sachi1645/Analog-PID-Motor-Speed-Controller/Presentation Slides/presentation.pptx

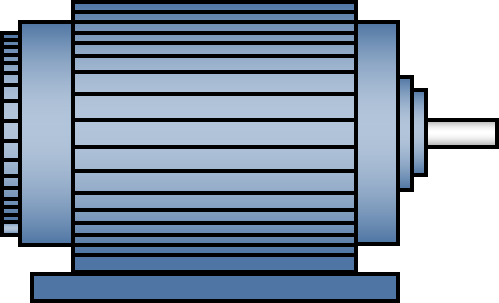
[picture p3: figure]
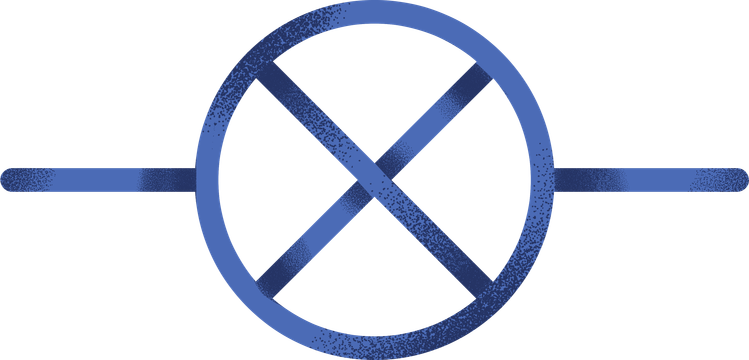
[picture p4: figure]

Group 13

PID Motor
Controller

EN2111 - Electronic Circuit Design

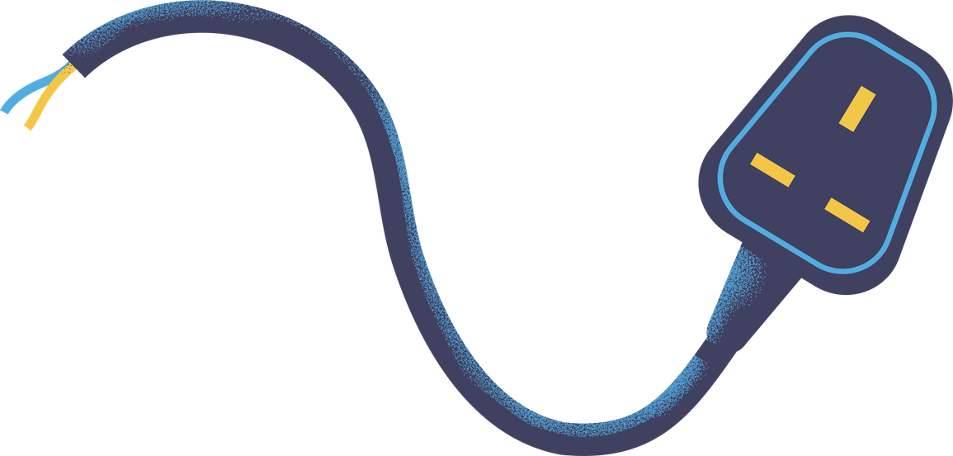
[picture p5: figure]
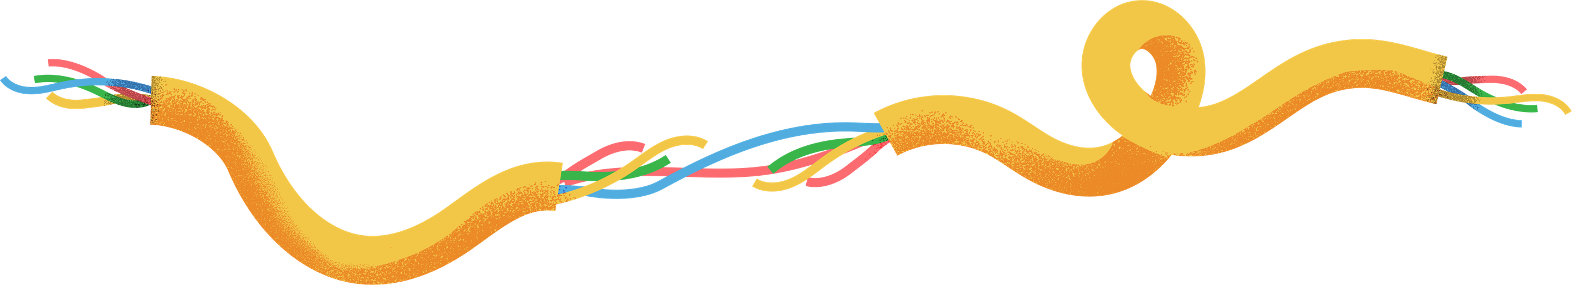
[picture p6: figure]

## Slide 2

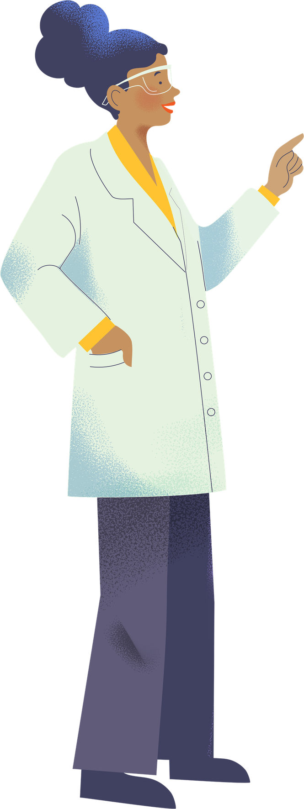
[picture p7: figure]

Introduction

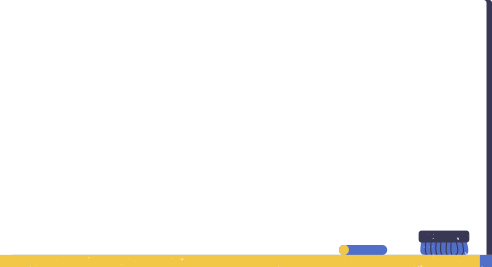
[picture p8: figure]

In this project, we design an analog PID-based motor speed controller that maintains constant motor speed despite load variations.The system uses
  - A reference speed input
  - Feedback from motor encoder
  - Analog PID control
  - PWM-based motor drive

## Slide 3

Block Diagram

1

FeedBack
Generation

  - F-V converter

2

PID Controller

  - Integrator
  - Differentiator
  - Differential Amplifier
  - Summing Amplifier

3

Driver Stage

  - PWM generator
(Relaxation Oscillator+
Integrator
Comparator)
  - Motor Driver

## Slide 4

FeedBack Generation

F-V Conversion

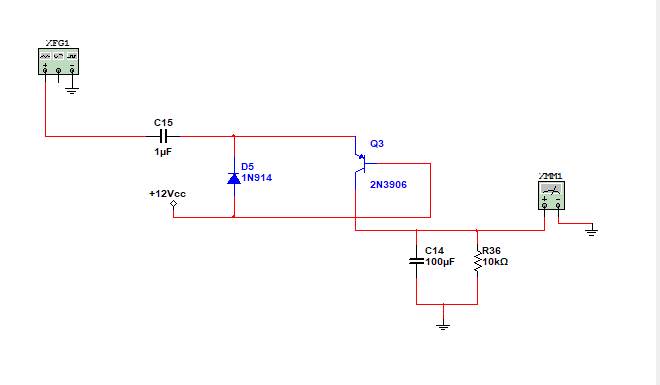
[picture p9: figure]

## Slide 5

PID Controller

This is the core of the system.
Reduce error between desired and actual speed
Improve stability and response
  - Proportional (P): reacts to present error
  - Integral (I): removes steady-state error
  - Derivative (D): reduces overshoot and improves stability
Implemented using op-amp networks

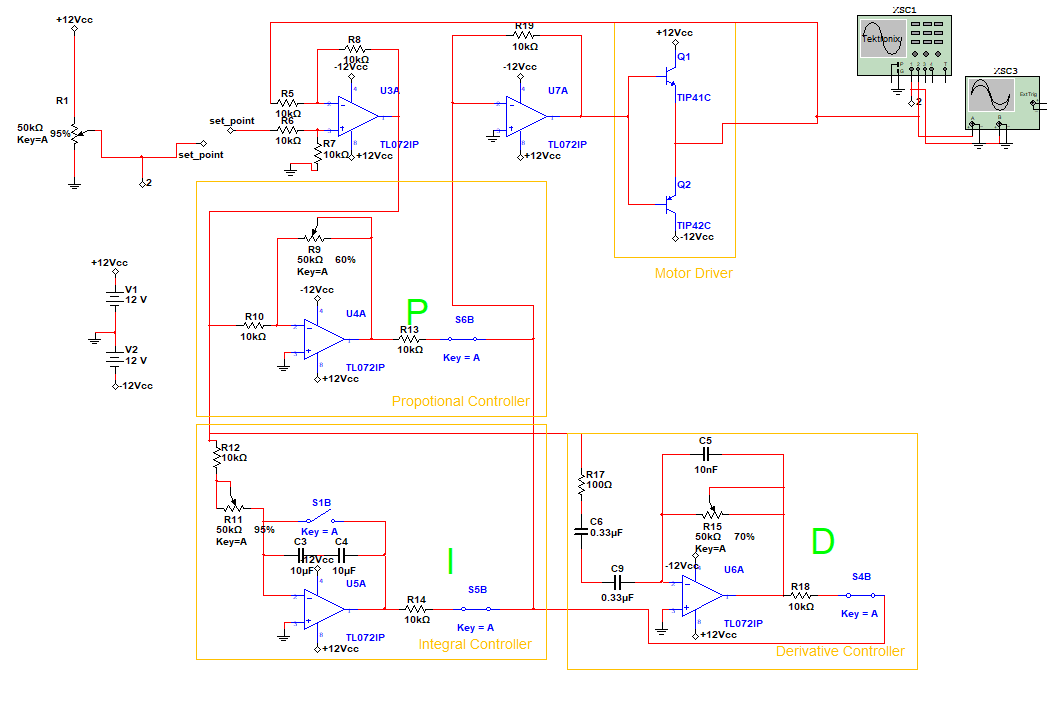
[picture p10: figure]

## Slide 6

PWM Generation

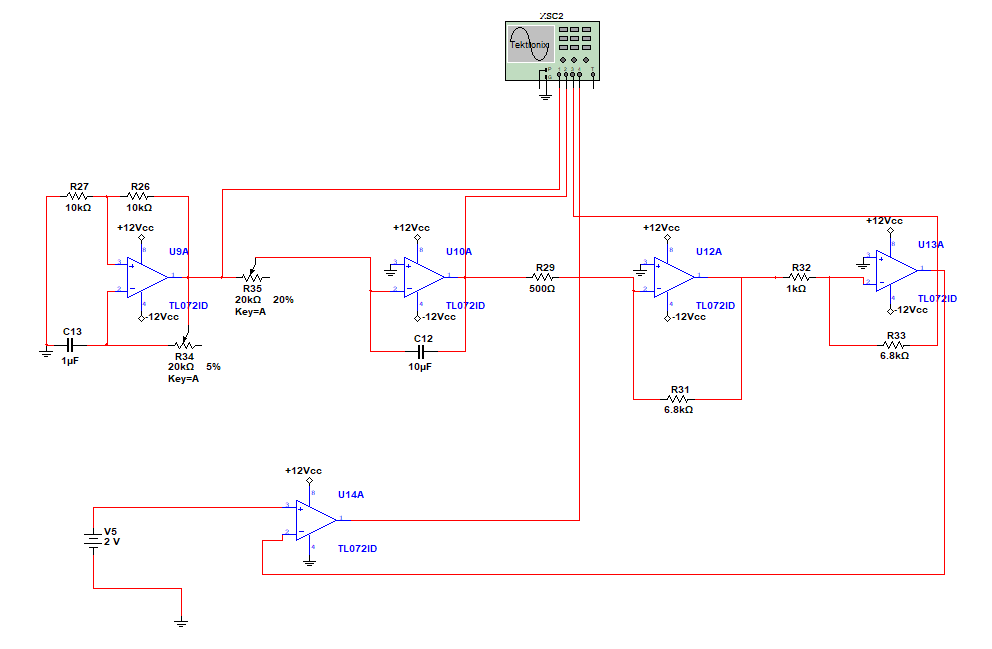
[picture p11: figure]

## Slide 7

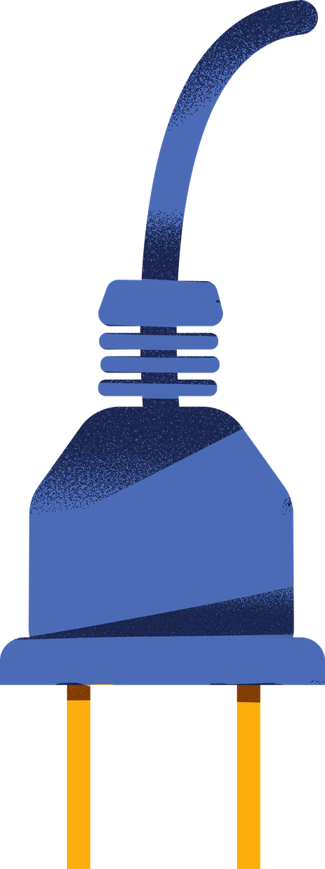
[picture p12: figure]

Op Amps-
  - TL071 - Has higher slew rate,low noise
  - LM741 -General purpose
Transistors-
  - 2N3906P-switching/amplification
  - TIP41C- Motor Driver
DIodes-
  - 1N914-Fast switching
Motor -
  - N20-built in magnetic encoder
Supply Voltage-
  - 6V
  - ±12V Dual Supply

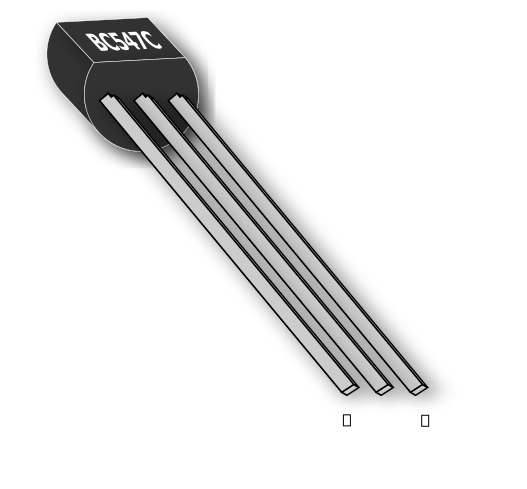
[picture p13: figure]

Component
Selection
&
Specification

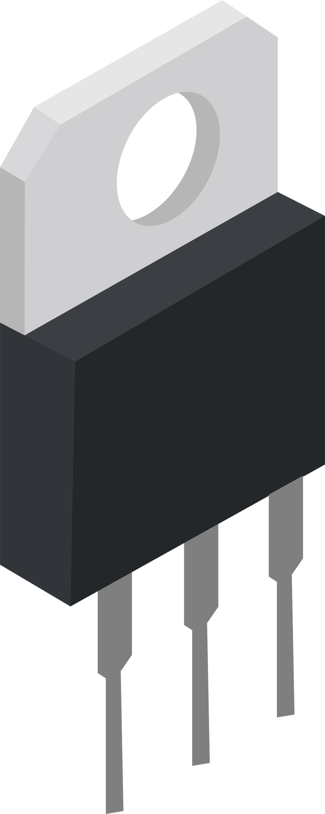
[picture p14: figure]
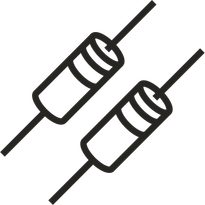
[picture p15: figure]
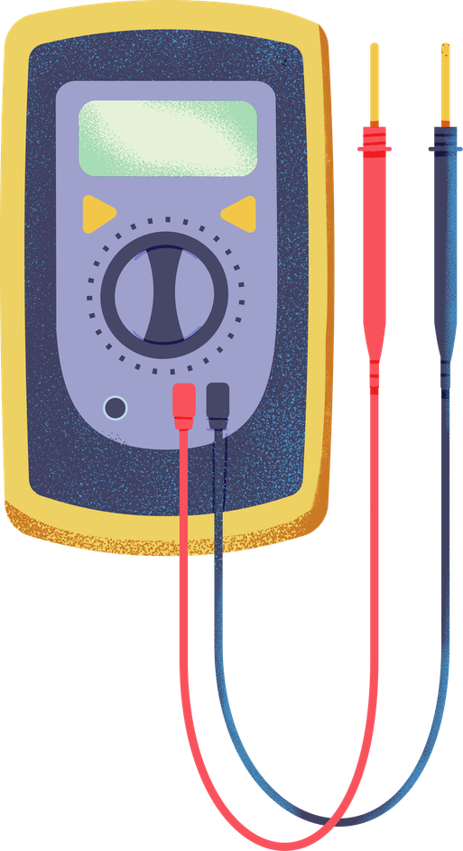
[picture p16: figure]

## Slide 8

Bread Board Implementation

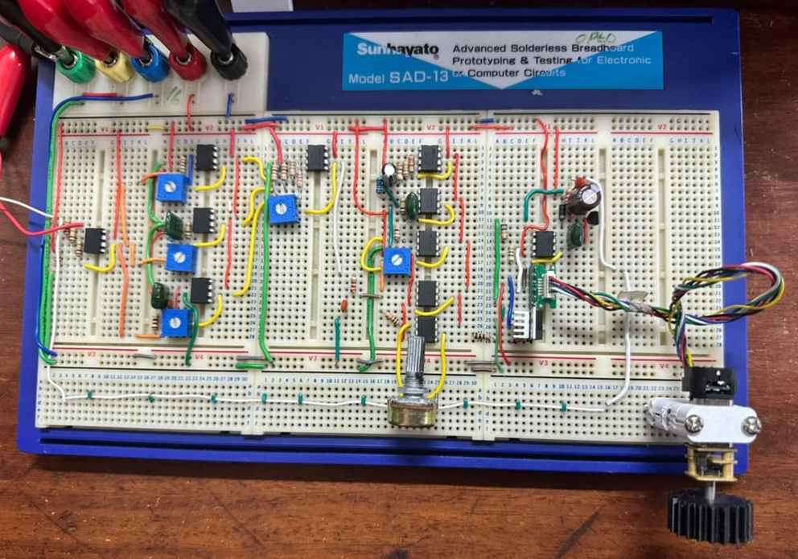
[picture p17: figure]
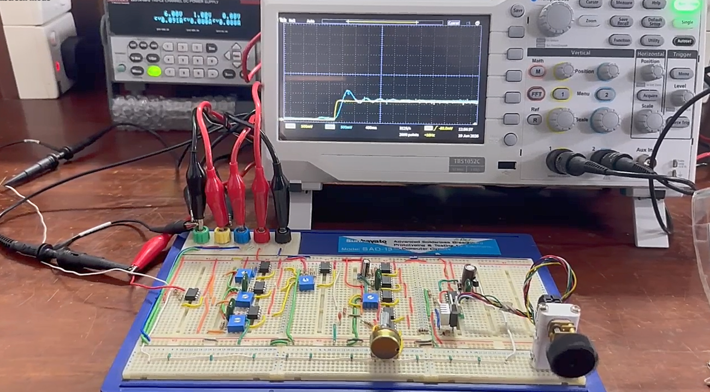
[picture p18: figure]
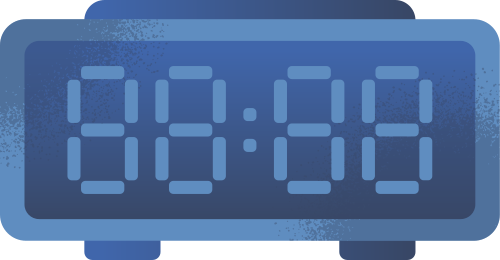
[picture p19: figure]

## Slide 9

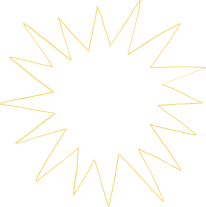
[picture p20: figure]
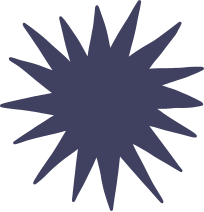
[picture p21: figure]

Thank You.

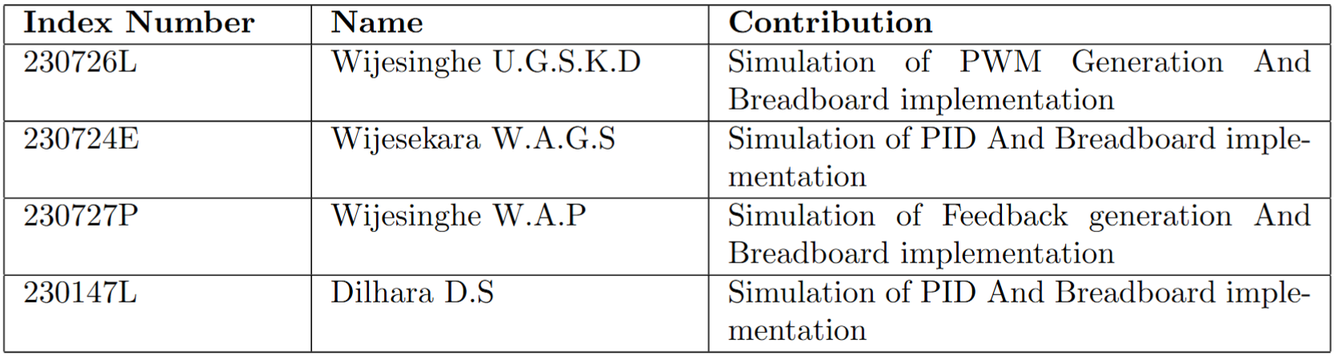
[picture p22: figure]
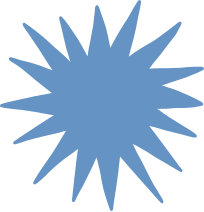
[picture p23: figure]
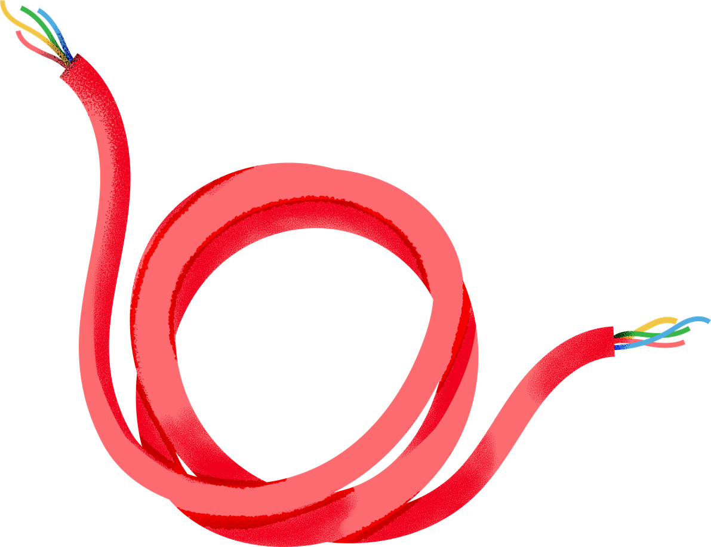
[picture p24: figure]
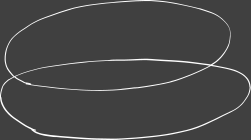
[picture p25: figure]
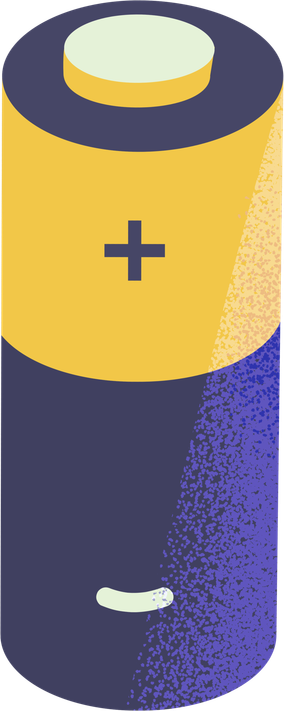
[picture p26: figure]
