sachi1645/Analog-PID-Motor-Speed-Controller/Project Report/project_report.pdf

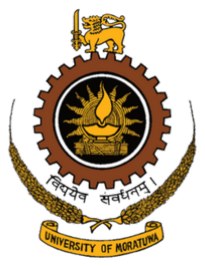
[picture p27: figure]

Department of Electronic & Telecommunication Engineering, University of Moratuwa, Sri Lanka.

# PID Motor Controller

Group Members:

230147L | Dilhara D.S
230724E | Wijesekara W.A.G.S
230726L | Wijesinghe U.G.S.K.D
230727P | Wijesinghe W.A.P

Submitted in partial fulfillment of the requirements for the module EN 2111 Electronic Circuit Design

22.06.2025

PID Motor Controller | Group 13

Abstract This project presents the design and implementation of an analog PID-based motor speed controller capable of maintaining a constant DC motor speed under varying load conditions. The system derives a feedback voltage proportional to motor speed through a frequency-to-voltage converter, compares it against a reference speed input, and processes the resulting error using an analog PID network built entirely from operational amplifiers. The controller output is converted into a duty-cycle-modulated PWM signal via a triangular-wave generator and comparator stage, which then drives the motor through an TIP31C Transistor. The system was simulated and tested to verify accurate, stable, and fast speed regulation across the target operating range.

1

## Contents

1 Introduction and Functionality | 3
2 System Architecture | 4
3 Component Selection | 7
4 Software Simulation and Hardware Testing | 8
5 Performance Parameters | 10
6 Conclusion & Future Works | 10
7 Contribution of Group Members | 11
8 Acknowledgment | 11
9 References | 11

2

## 1 Introduction and Functionality

Our project, “PID Motor Controller”, aims to demonstrate closed-loop analog control of DC motor speed using a Proportional-Integral-Derivative (PID) compensator built from op-amp circuits. The controller continuously compares the actual motor speed, obtained via feedback, against a userdefined reference speed, and adjusts the drive signal to the motor so that the speed error is driven toward zero, even in the presence of load disturbances.

### 1.1 Requirements

- Core Function: Maintain constant motor speed despite load variations
- Reference Input: Adjustable reference speed voltage
- Feedback: Motor speed sensed via encoder and converted to a proportional voltage
- Control: Analog PID compensation (Proportional, Integral, Derivative)
- Actuation: PWM-based motor drive through a Transistor
- Power Supply: Stable dual supply (±12 V) and 6 V motor supply

### 1.2 Design Considerations

- Analog Principles: Realize P, I, and D actions using op-amp integrator, differentiator, and summing/differential amplifier stages
- Feedback Path: Convert motor speed (frequency) into a clean, ripple-free voltage suitable for comparison
- Error Handling: Accurately compute the difference between reference and feedback signals
- PWM Generation: Generate a stable triangular carrier wave and compare it against the PID output to produce a duty-cycle-modulated drive signal
- Driver Stage: Provide sufficient current and isolation between the control circuitr and the motor
- Tuning: Allow adjustment of Kp, Ki
, and Kd via potentiometers to shape transient response
- Stability: Minimize overshoot and oscillation while keeping steady-state error low

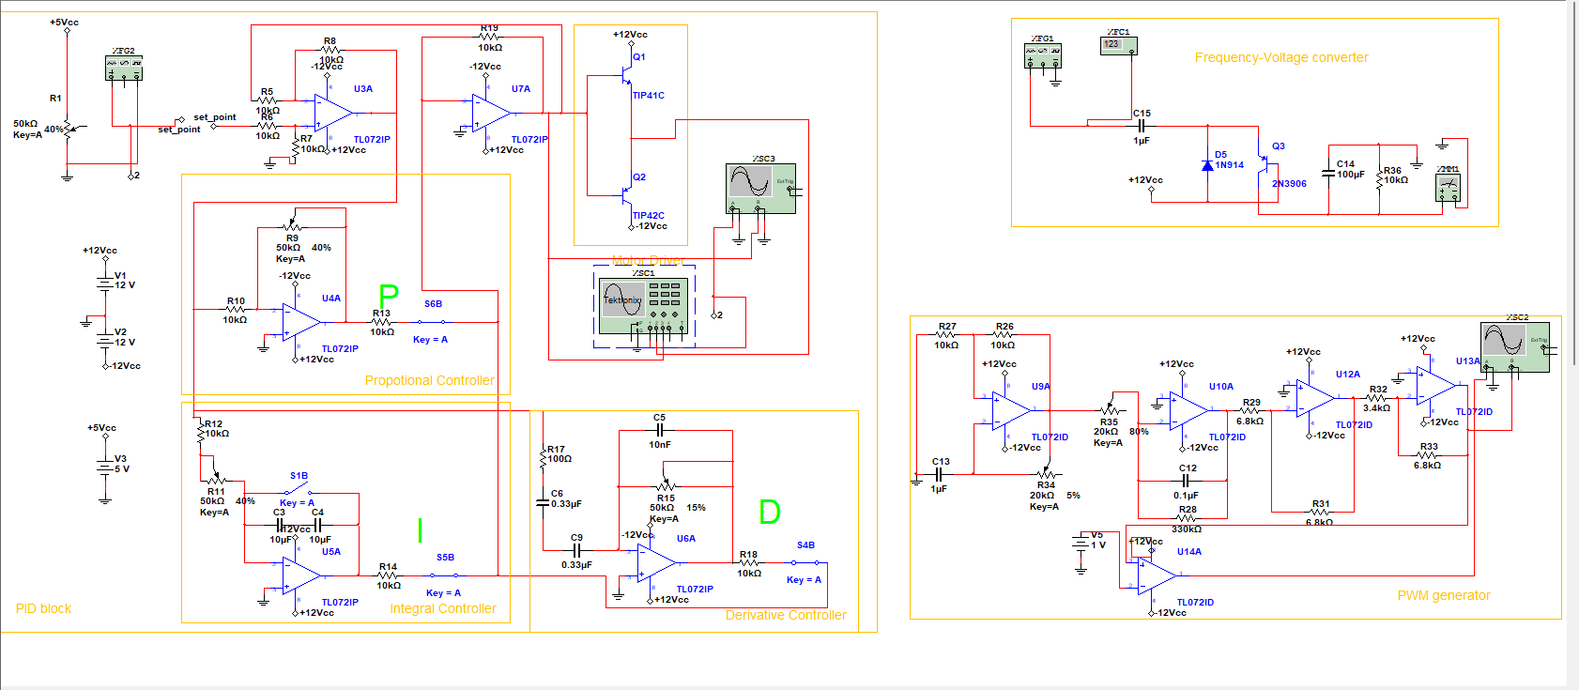
[picture p28: figure]

Figure 1: Overall System Block Diagram

3

## 2 System Architecture

The overall system consists of three main stages: Feedback Generation, the PID Controller, and the Driver Stage, as illustrated in the block diagram below.

### 2.1 Feedback Generation (F-V Converter)

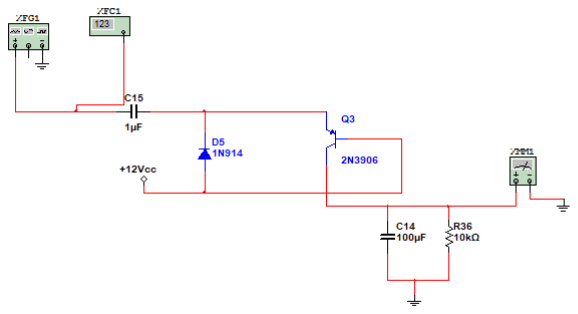
[picture p29: figure]

Figure 2: Frequency-to-Voltage Converter Circuit

Principle of Operation

- The motor’s built-in magnetic encoder produces a pulse train whose frequency is proportional to motor speed.
- This pulse train is AC-coupled through capacitor C15 and shaped by diode D5 and transistor Q3 to produce fixed-width current pulses for every encoder edge.
- The pulses are averaged by the low-pass filter formed by C14 and R36, producing a DC voltage proportional to pulse repetition rate.
- Since pulse frequency is directly proportional to motor speed, the resulting averaged voltage is also proportional to motor speed:

Vfb ∝ fenc ∝ ωmotor

- This feedback voltage Vfb is fed back to the PID controller for comparison against the reference voltage.

Derivation For a stable output level, the charge transferred from C15 to C14 must equal the charge lost each cycle from C14 through R36.

(VIN − VD5 − VBE,Q3) C15 =

T · VOUT

R36

VOUT =

C15R36
T

(VIN − VD5 − VBE,Q3)

VOUT = f · C15 · R36 · (VIN − VD5 − VBE,Q3) where f =

1
T

4

### 2.2 PID Controller


Figure 3: Analog PID Controller Circuit

Principle of Operation The controller computes the control signal u(t) from the instantaneous error e(t) = Vref − Vfb according to the standard PID law:

u(t) = Kp e(t) + Ki

Z t

0

e(τ ) dτ + Kd

de(t)
dt

### 2.2.1 Error Detection

A differential amplifier stage subtracts the feedback voltage from the reference voltage to generate the error signal, following the same principle as a standard op-amp subtractor:

e(t) = Vref − Vfb

### 2.2.2 Proportional Path

The error signal is scaled by an adjustable-gain inverting amplifier stage, with the gain potentiometer setting Kp:

VP = −

R9

R10

e(t) = Kp e(t)

### 2.2.3 Integral Path

- Apply KCL at the inverting node of the integrator op-amp (virtual ground):

e(t)

R11,12

+ C3,4

dVout
dt = 0
- Solving for Vout:

VI (t) = −

1

REqCEq Z t

0

e(τ ) dτ = Ki

Z t

0

e(τ ) dτ

5

### 2.2.4 Derivative Path

- Apply KCL at the inverting node of the differentiator op-amp, where the input current through capacitor C6 and C9 equals the feedback current through R15:

C6,9

de(t)
dt = −

Vout

R15

- Solving for Vout:

VD(t) = −R15CEq

de(t)
dt = Kd

de(t)
dt

### 2.2.5 Summing Stage

The three terms VP , VI , and VD are combined using a inverting summing amplifier to produce the final control output:
u(t) = VP + VI + VD

### 2.3 PWM Generation

Driving the motor with a duty-cycle-modulated square wave rather than a continuously variable analog voltage ,allows the use of an efficient switching motor driver stage, minimizing power dissipation in the driver while still delivering an effectively analog-controlled average voltage to the motor.


Figure 4: PWM Generation Circuit

Principle of Operation PWM generation is achieved using a triangular wave generator (formed from a relaxation oscillator and an integrator stage) followed by a voltage comparator.

1. Triangular Wave Generator: A square-wave relaxation oscillator drives an op-amp integrator, producing a linear triangular carrier waveform at a fixed switching frequency, set by RR26, R34, and C13.

6

2. Comparator: The triangular carrier is compared against the PID control voltage u(t). Whenever u(t) exceeds the instantaneous carrier level, the comparator output switches high, producing a rectangular pulse whose duty cycle is proportional to u(t):

D ∝ c(t)

### 2.4 Driver Stage

Principle of Operation The PWM signal is applied to the base of a TIP41C NPN power transistor, operating in a common-emitter switching configuration. The transistor switches the motor current on and off according to the PWM duty cycle, acting as the interface between the low-power analog control circuit and the higher-current motor circuit.
- When the PWM signal is high, the base current drives the TIP31C into saturation, connecting the motor across the supply through the collector-emitter path. When the PWM signal is low, the transistor turns off and motor current ceases.
- The average voltage delivered to the motor is approximately:

Vmotor, avg = D × Vsupply

- A flyback diode is connected across the motor terminals to protect the TIP31C from inductive voltage spikes generated by the motor windings when the transistor switches off.
- A base resistor limits the base current to a safe value while ensuring the transistor remains fully saturated at the expected motor current.

### 2.5 Power Supply

The control circuit is powered from a regulated ±12 V dual supply, while the motor is driven from a separate 6 V supply rail to prevent motor switching noise from coupling into the sensitive analog PID stages.

## 3 Component Selection

(a) | (b) | (c) | (d) | (e) | (f)
(a) TL071 Op-Amp – JFET-input operational amplifier with higher slew rate and low noise; used in the PWM generation stage where fast, clean switching transitions are required.
(b) LM741 Op-Amp – General-purpose operational amplifier; used throughout the feedback, error detection, and PID stages where high-speed performance is not critical.
(c) 2N3906 Transistor – PNP general-purpose transistor used for switching and signal conditioning in the frequency-to-voltage converter.
(d) 1N914 Diode – Fast-switching small-signal diode; used for pulse shaping in the feedback path and waveform clamping in the PWM generator.
(e) TIP41C Transistor – NPN power transistor switching the motor as collector load, base driven by the PWM signal. Supports up to 100 V and 6 A
(f) N20 DC Motor – Compact DC motor with a built-in magnetic encoder, used both as the actuator and as the speed-sensing element for the feedback loop.

7

## 4 Software Simulation and Hardware Testing

### 4.1 Simulations

All analog sub-circuits of the PID controllervwere evaluated using circuit simulation software prior to hardware implementation. Multisim is used to verify the transient response, gain accuracy and PWM switching behavior of each block under varying reference and load conditions.

### 4.1.1 Feedback Generation

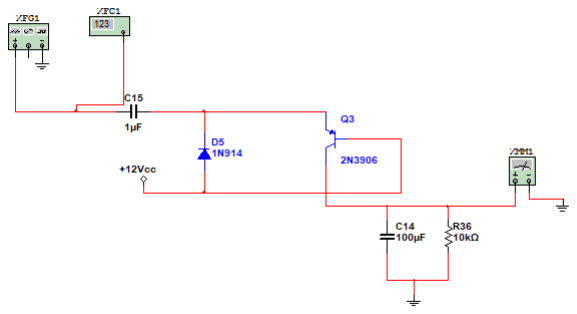
[picture p30: figure]

Figure 5: F–V Converter Simulation

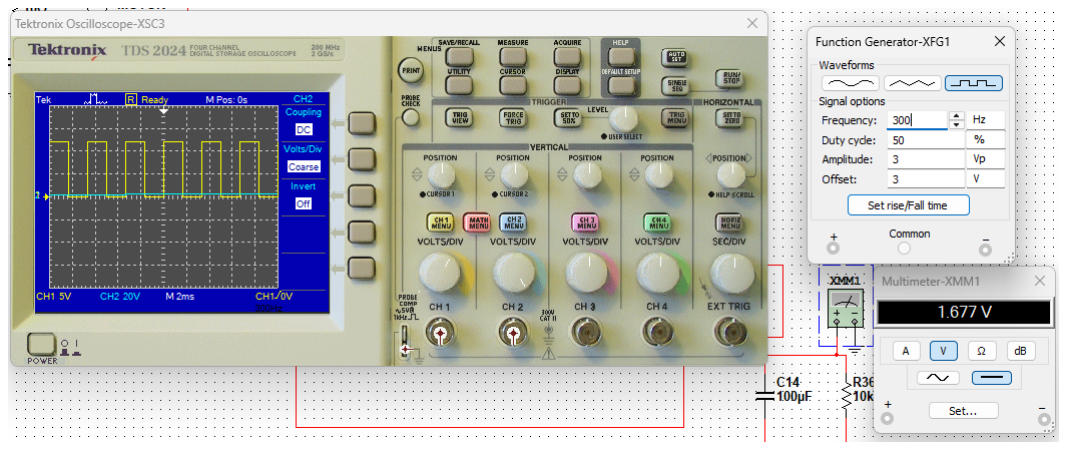
[picture p31: figure]

Figure 6: F–V Converter Output Waveform

### 4.1.2 PID Controller

Figure 7: PID Controller Simulation

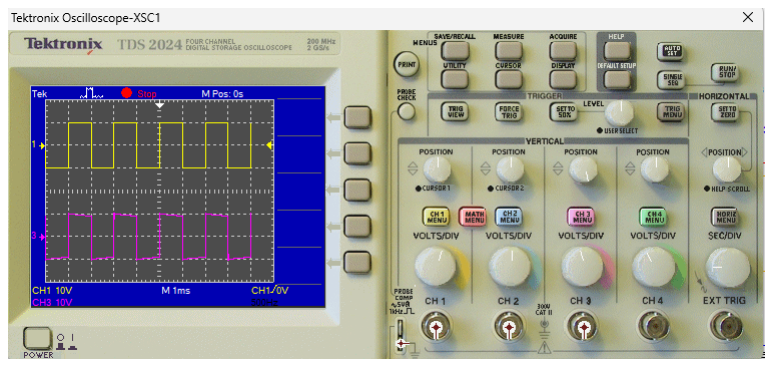
[picture p32: figure]

Figure 8: Step Response of the PID Output

8

### 4.1.3 PWM Generation

Figure 9: PWM Generator Simulation

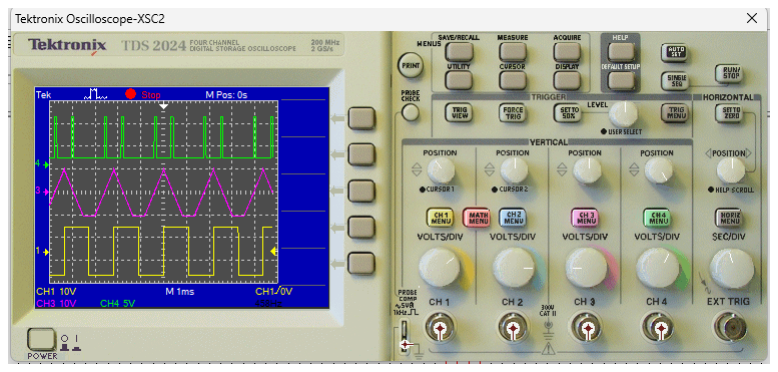
[picture p33: figure]

Figure 10: Triangular Carrier and PWM Output Waveforms

### 4.2 Hardware Testing

### 4.2.1 Breadboard Implementation

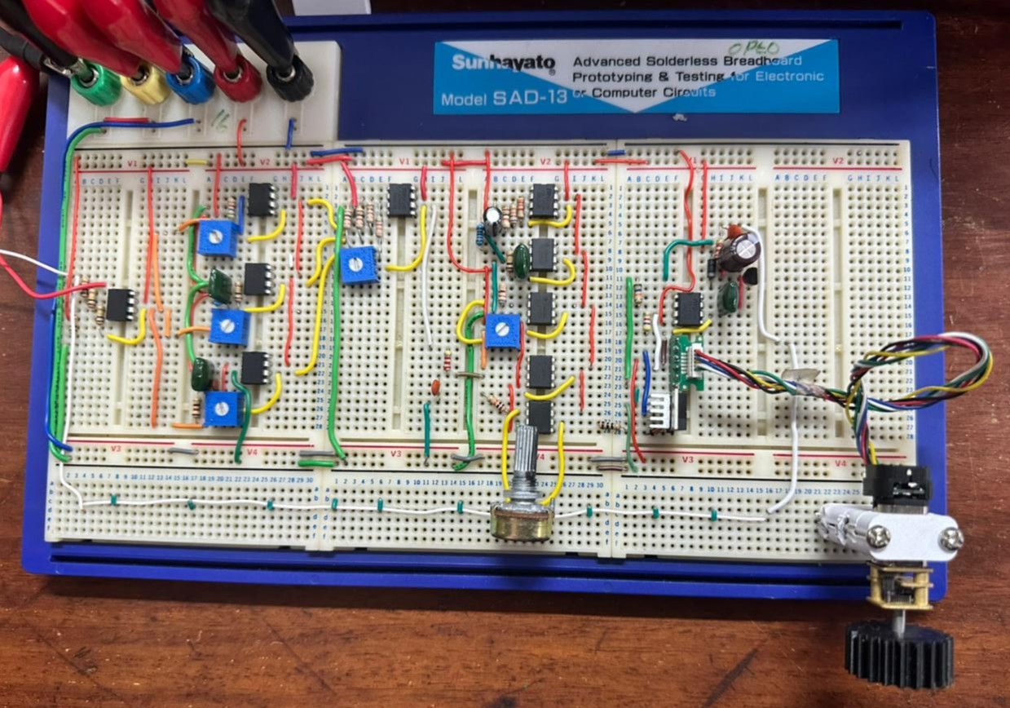
[picture p34: figure]

Figure 11: Breadboard Implementation – Close-up

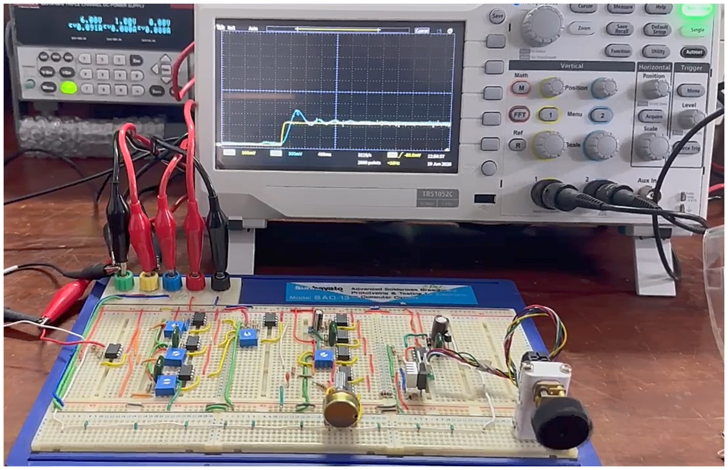
[picture p35: figure]

Figure 12: Breadboard Implementation – Overview

### 4.2.2 Step Response Testing

The system response to a step change in reference speed, and its disturbance rejection under sudden load application, were verified on the oscilloscope.

9

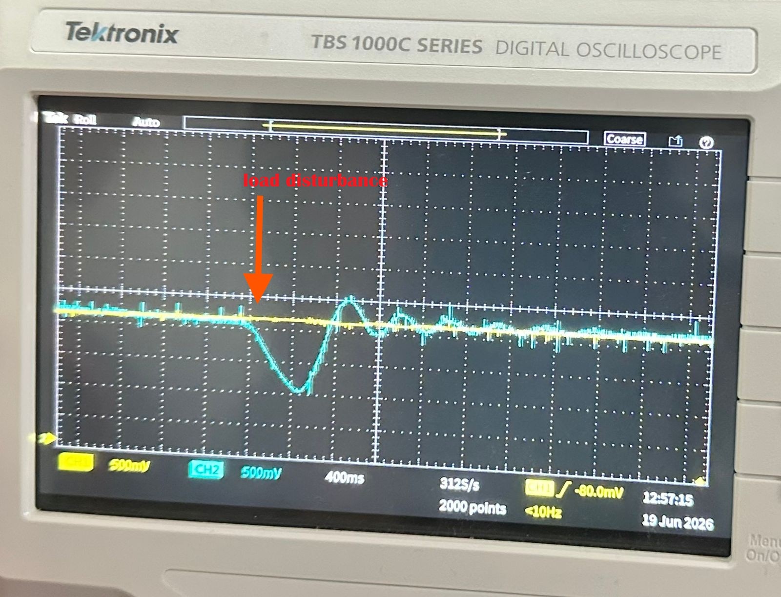
[picture p36: figure]
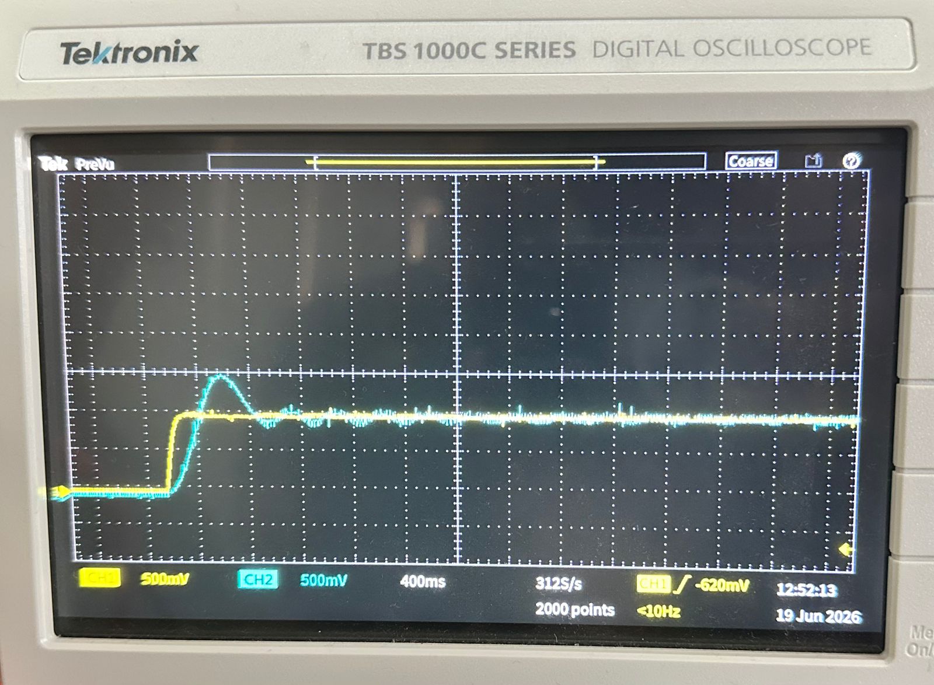
[picture p37: figure]

Figure 13: Measured Step Response | Figure 14: Response to Load Disturbance

Demonstration Videos:

1. Step Response: https://youtu.be/ZAlQ6-Eypqw
2. Response to Load Disturbance: https://youtu.be/ZAlQ6-Eypqw

## 5 Performance Parameters

Parameter | Condition | Min | Typical | Max | Units
Supply Voltage (Control) | Operating | N/A | ±12 | ±15 | V
Motor Supply Voltage | Operating | N/A | 6 | N/A | V
Reference Speed Range | Linear operation | N/A | N/A | 300 | rpm
Steady-State Error | Standard load | 0 | 0.1 | N/A | %
SNR | Standard load | 0.01 | 0.1 | N/A
Overshoot | Step response | N/A | 0.2 | N/A | %
Settling Time | Step input | N/A | N/A | 1 | s
Power Consumption | Nominal | N/A | N/A | 6 | W
Operating Temperature | | N/A | 25 | N/A | °C

Table 1: Performance parameters of the PID motor controller.

## 6 Conclusion & Future Works

The PID motor controller successfully regulates the speed of a DC motor using a fully analog closed-loop control system. The encoder-based feedback generation, PID compensation network, PWM generation circuit, and motor driver stage were individually verified through simulation and breadboard implementation. The integrated system demonstrated stable operation, effective disturbance rejection, and reduced steady-state error while maintaining the desired motor speed under varying operating conditions.
Future improvements include enhancing the PID controller by incorporating Kalman filtering techniques to improve noise rejection and state estimation accuracy. In addition, the motor driver stage can be upgraded to support bidirectional motor control, enabling the motor to rotate in both clockwise and counterclockwise directions. Further developments may also focus on improving control accuracy and extending the overall operating speed range of the system.

10

## 7 Contribution of Group Members

Index Number | Name | Contribution
230147L | Dilhara D.S | Simulation of PID And Breadboard imple-mentation
230724E | Wijesekara W.A.G.S | Simulation of PID And Breadboard imple-mentation
230726L | Wijesinghe U.G.S.K.D | Simulation of PWM Generation And Breadboard implementation
230727P | Wijesinghe W.A.P | Simulation of Feedback generation And Breadboard implementation

Table 2: Contribution of each group member

## 8 Acknowledgment

We extend our sincere appreciation to Dr.Wageesha Manamperi and Dr.Jayathu Samarawickrama for their invaluable guidance throughout the project. We also acknowledge their feedbacks, which improved our final design. We are grateful for the support from the ENTC academic and nonacademic staff throughout the project. Finally, we appreciate the efforts and contributions of all our group members, whose teamwork and dedication made the project successful.

## 9 References

1. Texas Instruments, LM741 Datasheet, https://www.ti.com/lit/ds/symlink/lm741.pdf.
2. 2N3906 Datasheet – General Purpose PNP Transistor, https://www.onsemi.com/download/datasheet/pdf/2n3906-d.pdf. (https://www.onsemi.com/download/data-sheet/pdf/2n3906-d.pdf)
3. 1N914 / 1N4148 Datasheet, https://www.vishay.com/docs/81857/1n4148.pdf.
4. TIP41C / TIP42C Datasheet, https://www.st.com/resource/en/datasheet/tip41c.pdf.
5. TL071 Datasheet, https://www.ti.com/lit/ds/symlink/tl071.pdf.
6. N20 DC Motor with Magnetic Encoder – Product Datasheet, https://www.adafruit.com/product/4640.
7. K. Ogata, Modern Control Engineering, 5th ed., Prentice Hall, 2010.
8. Op Amps for Everyone – Design Reference, https://www.ti.com/lit/an/slod006b/slod006b.pdf.

11
