sachi1645/Analog-PID-Motor-Speed-Controller/Breadboard Implementation/IMG-20260705-WA0003.jpg

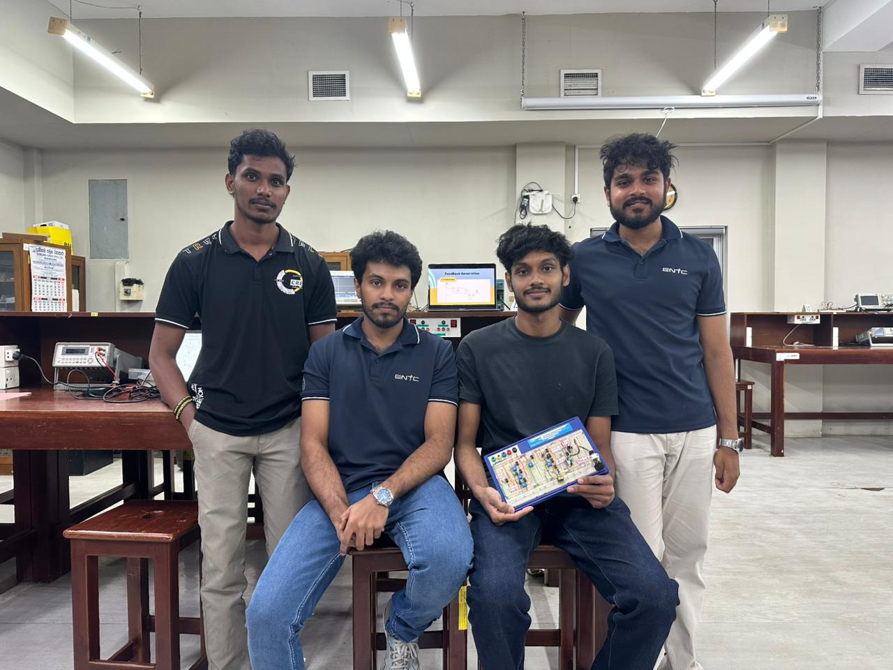
Breadboard Implementation/IMG-20260705-WA0003.jpg
