sachi1645/Analog-PID-Motor-Speed-Controller/(list of files, drawings)

Other design files:
Multisim Simulation/Analog PID Motor speed controller.ms11
